edson-acordi/4bit-microcomputer/Arduino/README.md

This folder contains an Arduino program to transfer a compiled program to MikroLeo.
