edson-acordi/4bit-microcomputer/Kicad-files/README.md

This folder contains the KiCad files for Mikroleo.
