edson-acordi/4bit-microcomputer/Kicad-files/7Segment-CC/README.md

A simple seven-segment display interfaces for the MikroLeo to show hexadecimal numbers.

KiCad PCB 3D viewer:  
