edson-acordi/4bit-microcomputer/Programs/asm/vga/README.md

This folder contains some assembly language programs for MikroLeo to generate a VGA signal.
