edson-acordi/4bit-microcomputer/Kicad-files/MikroLeo/Gerber/README.md

This folder contains the Gerber files to be sent for MikroLeo PCB production.
