edson-acordi/4bit-microcomputer/Kicad-files/7Segment-CC/Gerber/README.md

This folder contains the Gerber files to be sent for 7 Segment Display PCB production.
