edson-acordi/4bit-microcomputer/Photo-Gallery/README.md

## **First steps:** ##
- Program Counter (PC)
- Reset Circuit


## **Second steps:** ##
- Program Memory (implemented with RAM)
- ROM Buffer
- Instruction Decoder (IR)
  

**Testing Pogram Memory data Retention,**
- Supercap 1.5F x 5.5V


## **Third steps:** ##
- Control Unit (UC)
  
  

## **Simposium:** ##
- Presentation at Simproin 2022
