edson-acordi/4bit-microcomputer/Programs/asm/Instruction_test/README.md

This folder holds some programs in asm code for testing with MikroLeo.
