edson-acordi/4bit-microcomputer/Docs/MikroLeo_Instruction_SET_last.pdf

## MikroLeo Instruction Set

Instruction Hex Code | Encoding of MikroLeo Instruction Word (16-bits) | | Instructions with all possibilities | Operation | Affected Flags
ROMH (8-bit) | ROML (8-bit)
High Nibble (HiNB) | Decoder Address | MAddr | Operand/LAddr
ROM (16-bit) | MICRO2_IN | AMODE | MOD | MICRO
b15 | b14 | b13:b12 | b11:b8 | b7:b4 | b3:b0
00Xn 10Xn 20Xn 30Xn | | X | 0 | 0 | X | n | LDI | LDI ACC,n | ACC ← n | ZF
| | | 1 | | | | | LDI RA,n | RA ← n | -
| | | 2 | | | | | LDI RB,n | RB ← n
| | | 3 | | | | | LDI RC,n | RC ← n
01Xn 11XX 21XX 31mn 71XX | | | 0 | 1 | X | n | NAND | NAND ACC,n | ACC ← ACC NAND n | ZF
| | | 1 | | | X | | NAND ACC,RA | ACC ← ACC NAND RA
| | | 2 | | | | | NAND ACC,RB | ACC ← ACC NAND RB
| | 0 | 3 | | MAddr | LAddr | | NAND ACC,RAM[Addr] | ACC ← ACC NAND RAM[RC:MAddr:LAddr]
| | 1 | | | X | X | | | ACC ← ACC NAND RAM[RC:RB:RA]
02mn 42XX | | 0 | 0 | 2 | MAddr | LAddr | LDW | LDW ACC,RAM[Addr] | ACC ← RAM[RC:MAddr:LAddr] | ZF
| | 1 | | | X | X | | | ACC ← RAM[RC:RB:RA]
13XX 23XX 33XX | | X | 1 | 3 | X | X | LDA | LDA RA | ACC ← RA | ZF
| | | 2 | | | | | LDA RB | ACC ← RB
| | | 3 | | | | | LDA RC | ACC ← RC
04Xn 14XX 24XX 34mn 74XX | | | 0 | 4 | X | n | OUTA | OUTA n | OUTA ← n | -
| | | 1 | | | X | | OUTA ACC | OUTA ← ACC
| | | 2 | | | | | OUTA RA | OUTA ← RA
| | 0 | 3 | | MAddr | LAddr | | OUTA RAM[Addr] | OUTA ← RAM[RC:MAddr:LAddr]
| | 1 | | | X | X | | | OUTA ← RAM[RC:RB:RA]
05Xn 15XX 25XX 35mn 75XX | | X | 0 | 5 | X | n | OUTB | OUTB n | OUTB ← n | -
| | | 1 | | | X | | OUTB ACC | OUTB ← ACC
| | | 2 | | | | | OUTB RA | OUTB ← RA
| | 0 | 3 | | MAddr | LAddr | | OUTB RAM[Addr] | OUTB ← RAM[RC:MAddr:LAddr]
| | 1 | | | X | X | | | OUTB ← RAM[RC:RB:RA]
06Xn 16XX 26XX 36mn 76XX | | X | 0 | 6 | X | n | OUTC | OUTC n | OUTC ← n | -
| | | 1 | | | X | | OUTC ACC | OUTC ← ACC
| | | 2 | | | | | OUTC RA | OUTC ← RA
| | 0 | 3 | | MAddr | LAddr | | OUTC RAM[Addr] | OUTC ← RAM[RC:MAddr:LAddr]
| | 1 | | | X | X | | | OUTC ← RAM[RC:RB:RA]
07XX | | X | 0 | 7 | X | X | NOP | NOP | No Operation | -
17XX 27XX 37XX | | | 1 | | X | X | LDR | LDR RA | RA ← ACC | -
| | | 2 | | | | | LDR RB | RB ← ACC
| | | 3 | | | | | LDR RC | RC ← ACC
08Xn 18XX 28XX 38mn 78XX | | | 0 | 8 | X | n | CMP | CMP ACC,n | ACC - n | CF, ZF
| | | 1 | | | X | | CMP ACC,RA | ACC - RA
| | | 2 | | | | | CMP ACC,RB | ACC - RB
| | 0 | 3 | | MAddr | LAddr | | CMP ACC,RAM[Addr] | ACC - RAM[RC:MAddr:LAddr]
| | 1 | | | X | X | | | ACC - RAM[RC:RB:RA]
09Xn 19XX 29XX 39mn 79XX | | X | 0 | 9 | X | n | OUTD | OUTD n | OUTD ← n | -
| | | 1 | | | X | | OUTD ACC | OUTD ← ACC
| | | 2 | | | | | OUTD RA | OUTD ← RA
| | 0 | 3 | | MAddr | LAddr | | OUTD RAM[Addr] | OUTD ← RAM[RC:MAddr:LAddr]
| | 1 | | | | | | | OUTD ← RAM[RC:RB:RA]
0Amn 4AXX | | 0 | 0 | Ah | MAddr | LAddr | STW | STW RAM[Addr],ACC | RAM[RC:MAddr:LAddr] ← ACC | -
| | 1 | | | X | X | | | RAM[RC:RB:RA] ← ACC
0BXn 1BXX 2BXX 3Bmn 7BXX | | X | 0 | Bh | X | n | SUB | SUB ACC,n | ACC ← ACC - n | CF, ZF
| | | 1 | | | X | | SUB ACC,RA | ACC ← ACC - RA
| | | 2 | | | | | SUB ACC,RB | ACC ← ACC - RB
| | 0 | 3 | | MAddr | LAddr | | SUB ACC,RAM[Addr] | ACC ← ACC - RAM[RC:MAddr:LAddr]
| | 1 | | | X | X | | | ACC ← ACC - RAM[RC:RB:RA]
0Cmn 4CXX | | 0 | 0 | Ch | MAddr | LAddr | JPI | JPI RC:MA[7:4]:LA[3:0] | PC ← [RC:MAddr:LAddr] | -
| | 1 | | | X | X | | | PC ← [RC:RB:RA]
0Dmn 4DXX | | 0 | 0 | Dh | MAddr | LAddr | JPC | JPC MA[7:4]:LA[3:0] | If CF=1, PC ← [PCH:MAddr:LAddr]
| | 1 | | | X | X | | | If CF=1, PC ← [PCH:RB:RA]
0Emn 4EXX | | 0 | 0 | Eh | MAddr | LAddr | JPZ | JPZ MA[7:4]:LA[3:0] | If ZF=1, PC ← [PCH:MAddr:LAddr]
| | 1 | | | X | X | | | If ZF=1, PC [PCH:RB:RA] ←
0FXn 1FXX 2FXX 3Fmn 7FXX | | X | 0 | Fh | X | n | ADD | ADD ACC,n | ACC ← ACC + n | CF, ZF
| | | 1 | | | X | | ADD ACC,RA | ACC ← ACC + RA
| | | 2 | | | | | ADD ACC,RB | ACC ← ACC + RB
| | 0 | 3 | | MAddr | LAddr | | ADD ACC,RAM[Addr] | ACC ← ACC + RAM[RC:MAddr:LAddr]
| | 1 | | | X | X | | | ACC ← ACC + RAM[RC:RB:RA]
8XXX 9XXX AXXX BXXX | 1 | X | 0 | X | | | INA | INA | ACC ← INA | ZF
| | | 1 | | | | INB | INB | ACC ← INB
| | | 2 | | | | INC | INC | ACC ← INC
| | | 3 | | | | IND | IND | ACC ← IND

## Mnemonic

0

LA[3:0] => can be RA or Operand (LAddr), depends on the AMODE bit. | AMODE = Addresing mode (b14)
MA[7:4] => can be RB or MAddr, depends on the AMODE bit. | MOD = Modifier bits (b13:b12)
Address = Addr => RC:MA[7:4]:LA[3:0] | MAddr = Medium Address (b7:b4)
If AMODE=0, Addr=RC:Maddr:LAddr | LAddr = Low Address (b3:b0)
If AMODE=1, Addr=RC:RB:RA | MICRO = Instruction (b11:b8)
X = don't care | OPCODE = AMODE:MOD:MICRO
MAddr = m, so the names are interchangeable | ZF = Zero Flag
Operand = n, so the names are interchangeable | CF = Carry Flag
