edson-acordi/4bit-microcomputer/Docs/FAQ.md

### Frequently Asked Questions about MikroLeo ###  

**1) What is MikoLeo?**  
A: MikroLeo is a 4-bit microcomputer developed mainly for educational purposes and distributed for free under open-source licenses.
