edson-acordi/4bit-microcomputer/Docs/MikroLeo_v0.1901_Rev1.01A_sch.pdf

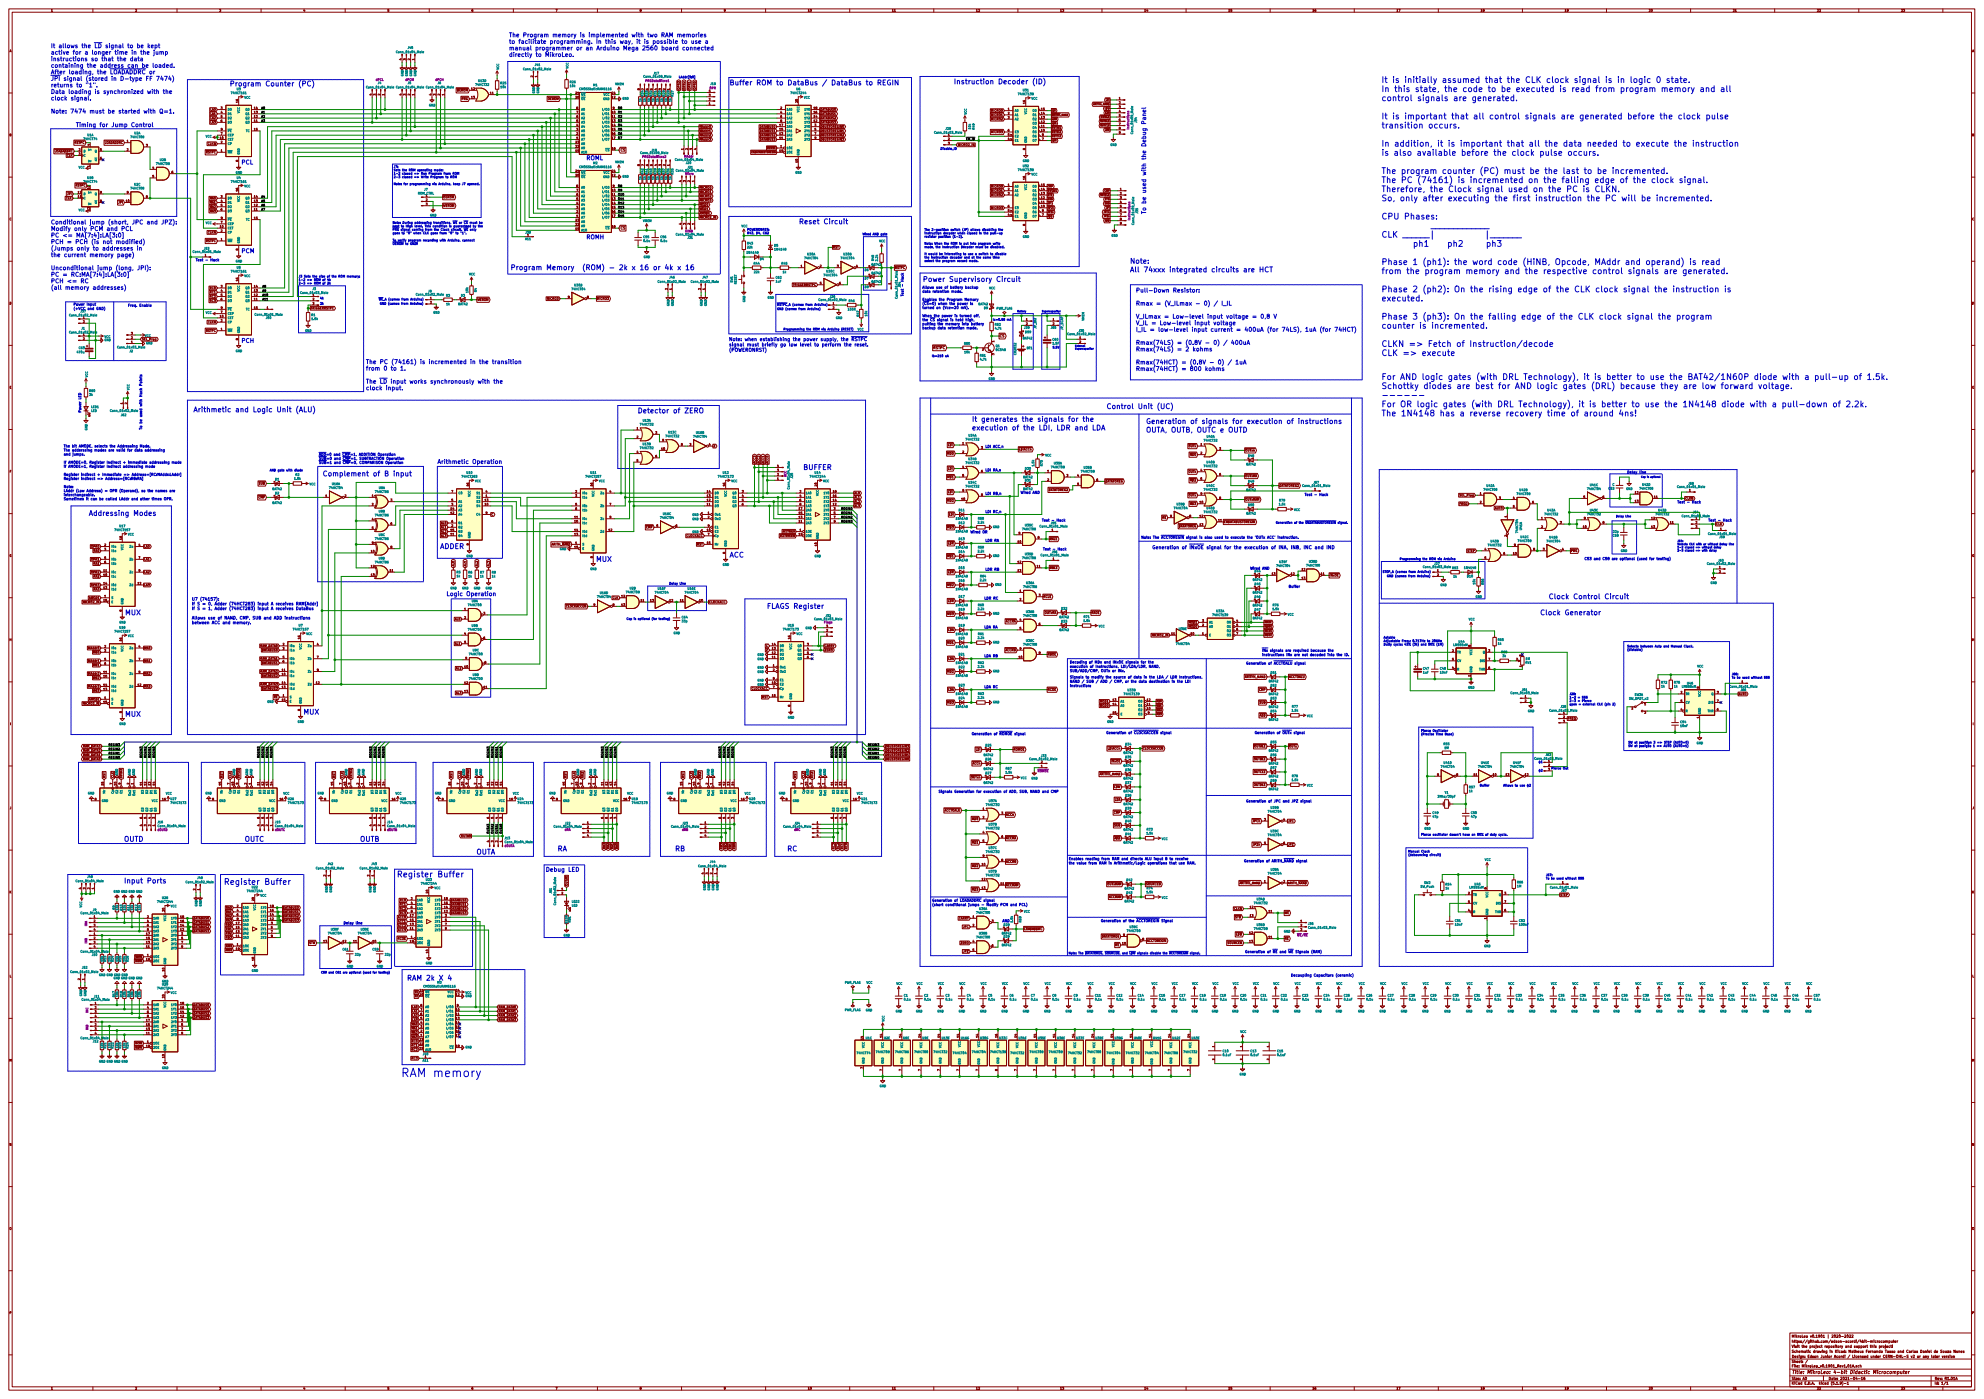
[picture p14: page 1]

The Program memory is implemented with two RAM memories
to facilitate programming. In this way, it is possible to use a
manual programmer or an Arduino Mega 2560 board connected
directly to MikroLeo.

It allows the LD signal to be kept
active for a longer time in the jump
instructions so that the data
containing the address can be loaded.
After loading, the LOADADDRC or
JPI signal (stored in D-type FF 7474)
returns to "1".

Buffer ROM to DataBus / DataBus to REGIN

It is initially assumed that the CLK clock signal is in logic 0 state.
In this state, the code to be executed is read from program memory and all

Data loading is synchronized with the
clock signal.

control signals are generated.

Note: 7474 must be started with Q=1.

It is important that all control signals are generated before the clock pulse
transition occurs.

DATABUS2 RSTPC
Timing for Jump Control

In addition, it is important that all the data needed to execute the instruction
is also available before the clock pulse occurs.

select the program record mode. J7: Sets the ROM operating mode:

The program counter (PC) must be the last to be incremented.
The PC (74161) is incremented on the falling edge of the clock signal.
Therefore, the Clock signal used on the PC is CLKN.
So, only after executing the first instruction the PC will be incremented.

1-2 closed => Run Program from ROM
2-3 closed => Write Program to ROM

Note: for programming via Arduino, keep J7 opened.

Modify only PCM and PCL
PCH = PCH (is not modified)
(Jumps only to addresses in
the current memory page)

Note: During addressing transitions, WE or CS must be
kept to High level. This condition is guaranteed by the
PRG signal coming from the Clock circuit. WE only
goes to "0" when CLK goes from "0" to "1".

The 2-position switch (JP) allows disabling the
instruction decoder when closed in the pull-up
resistor position (1-2).

To verify program recording with Arduino, connect OEROM to GND! 2k

Note: When the ROM is put into program write mode, the Instruction Decoder must be disabled.

It would be interesting to use a switch to disable
the instruction decoder and at the same time

Note:
All 74xxx integrated circuits are HCT

Phase 1 (ph1): the word code (HiNB, Opcode, MAddr and operand) is read
from the program memory and the respective control signals are generated.

Unconditional jump (long, JPI):
PCH <= RC

J3 Sets the size of the ROM memory: 1-2 => ROM of 4k 2-3 => ROM of 2k

Allows use of battery backup
data retention mode. Enables the Program Memory

Phase 2 (ph2): On the rising edge of the CLK clock signal the instruction is
executed.

WE_A (comes from Arduino)
GND (comes from Arduino)

RSTPC_A (comes from Arduino)

(CS=0) when the power is
turned on (Vce=20 mV).

Battery ADD=0 and CMP=1, ADDITION Operation

Phase 3 (ph3): On the falling edge of the CLK clock signal the program
counter is incremented.

When the power is turned off,
the CS signal is held high,
putting the memory into battery

V_ILmax = Low-level input voltage = 0,8 V
V_IL = Low-level input voltage
I_IL = low-level input current = 400uA (for 74LS), 1uA (for 74HCT)

Programming the ROM via Arduino (RESET)

Note: when establishing the power supply, the RSTPC
signal must briefly go low level to perform the reset.
(POWERONRST)

CLKN => Fetch of Instruction/decode
CLK => execute

The PC (74161) is incremented in the transition
from 0 to 1.

For AND logic gates (with DRL Technology), it is better to use the BAT42/1N60P diode with a pull-up of 1.5k.
Schottky diodes are best for AND logic gates (DRL) because they are low forward voltage. ------ For OR logic gates (with DRL Technology), it is better to use the 1N4148 diode with a pull-down of 2.2k.

The LD input works synchronously with the
clock input.

Logic Operation To be used with Hack Points

LDI ACC,n Power LED

Arithmetic and Logic Unit (ALU)

The 1N4148 has a reverse recovery time of around 4ns!

It generates the signals for the
execution of the LDI, LDR and LDA

Generation of signals for execution of instructions
OUTA, OUTB, OUTC e OUTD

The bit AMODE, selects the Addressing Mode.
The adderssing modes are valid for data addressing
and jumps.

SUB=0 and CMP=1, SUBTRACTION Operation
SUB=1 and CMP=0, COMPARISON Operation
Complement of B input

If AMODE=0, Register Indirect + immediate addressing mode
if AMODE=1, Register Indirect addressing mode

LDI RAM_DATA0
AND gate with diode

Register indirect + Immediate => Address=[RC:MAddr:LAddr]
Register indirect => Address=[RC:RB:RA] Note: LAddr (Low Address) = OPR (Operand), so the names are

Cap is optional RAM memory

Test - Hack Generation of OUTx signal

Allows to use 2 Addressing Modes

Generation of the ENDATABUSTOREGIN signal.

Note: The ACCTOREGIN signal is also used to execute the 'OUTx ACC' instruction.
Generation of INxOE signal for the execution of INA, INB, INC and IND

J64: Selects CLK with or without Delay line

1-2 closed => without delay 2-3 closed => with delay

Programming the ROM via Arduino

C53 and C58 are optional (used for testing)

STEP_A (comes from Arduino)

If S = 0, Adder (74HCT283) input A receives RAM[Addr]
If S = 1, Adder (74HCT283) input A receives DataBus

Allows use of NAND, CMP, SUB and ADD instructions
between ACC and memory.

Cap is optional (for testing)

Astable Adjustable Freq.: 0.717Hz to 206Hz

GND GND GND GND GND

Selects between Auto and Manual Clock. (bistable)

INx signals are required because the
instructions INx are not decoded into the ID.

Decoding of MDx and INxOE signals for the
execution of Instructions, LDI/LDA/LDR, NAND,
SUB/ADD/CMP, OUTx or INx.
Signals to modify the source of data in the LDA / LDR Instructions,
NAND / SUB / ADD / CMP, or the data destination in the LDI

J66: To be used without 555

2-3 = Pierce
open = external CLK (pin 2)

SW at position 3 => STEP (AUTO=0)
SW at posição 1 => AUTO (AUTO=1)

2 Enables reading from RAM and directs ALU input B to receive

Signals Generation for execution of ADD, SUB, NAND and CMP

Generation of JPC and JPZ signal

Pierce oscillator doesn't have an 50% of duty cycle.

the value from RAM in Arithmetic/Logic operations that use RAM.

J67: To be used without 555

Generation of LOADADDRC signal
(short conditional jumps - Modify PCM and PCL)

Note: The DATATOREG, SOURCEB, and LDW signals disable the ACCTOREGIN signal.

Generation of RE and WE Signals (RAM)

C59 and C61 are optional (used for testing)

VCC GND VCC 14 GND

MikroLeo v0.1901 | 2020-2022
https://github.com/edson-acordi/4bit-microcomputer
Visit the project repository and support this project!
Schematic drawing in Kicad: Matheus Fernando Tasso and Carlos Daniel de Souza Nunes
File: MikroLeo_v0.1901_Rev1.01A.sch Sheet: / Design: Edson Junior Acordi / Licensed under CERN-OHL-S v2 or any later version

Id: 1/1 Title: MikroLeo: 4-bit Didactic Microcomputer
