edson-acordi/4bit-microcomputer/Docs/7Segment_CC_Bin_Hex_sch.pdf

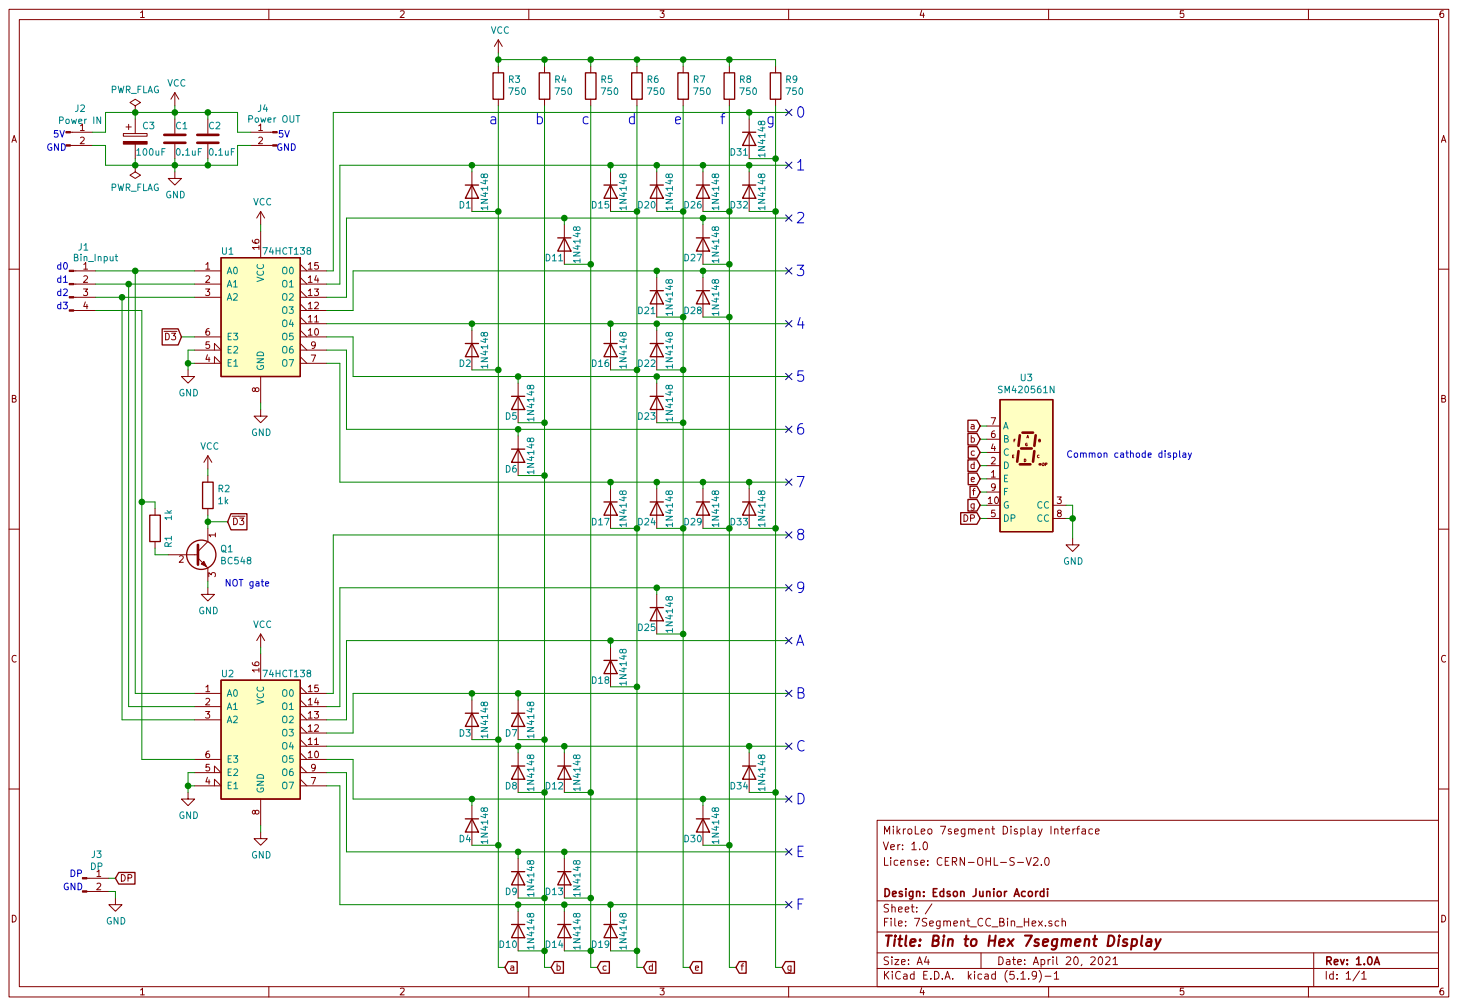
[picture p15: page 1]

NOT gate DP GND

File: 7Segment_CC_Bin_Hex.sch Sheet: / Design: Edson Junior Acordi License: CERN-OHL-S-V2.0 Ver: 1.0 MikroLeo 7segment Display Interface

Id: 1/1 Title: Bin to Hex 7segment Display
