edson-acordi/4bit-microcomputer/Docs/VGA/Updated VGA Flowchart.pdf

## Flowchart for generating a 640x480 VGA image at 60Hz

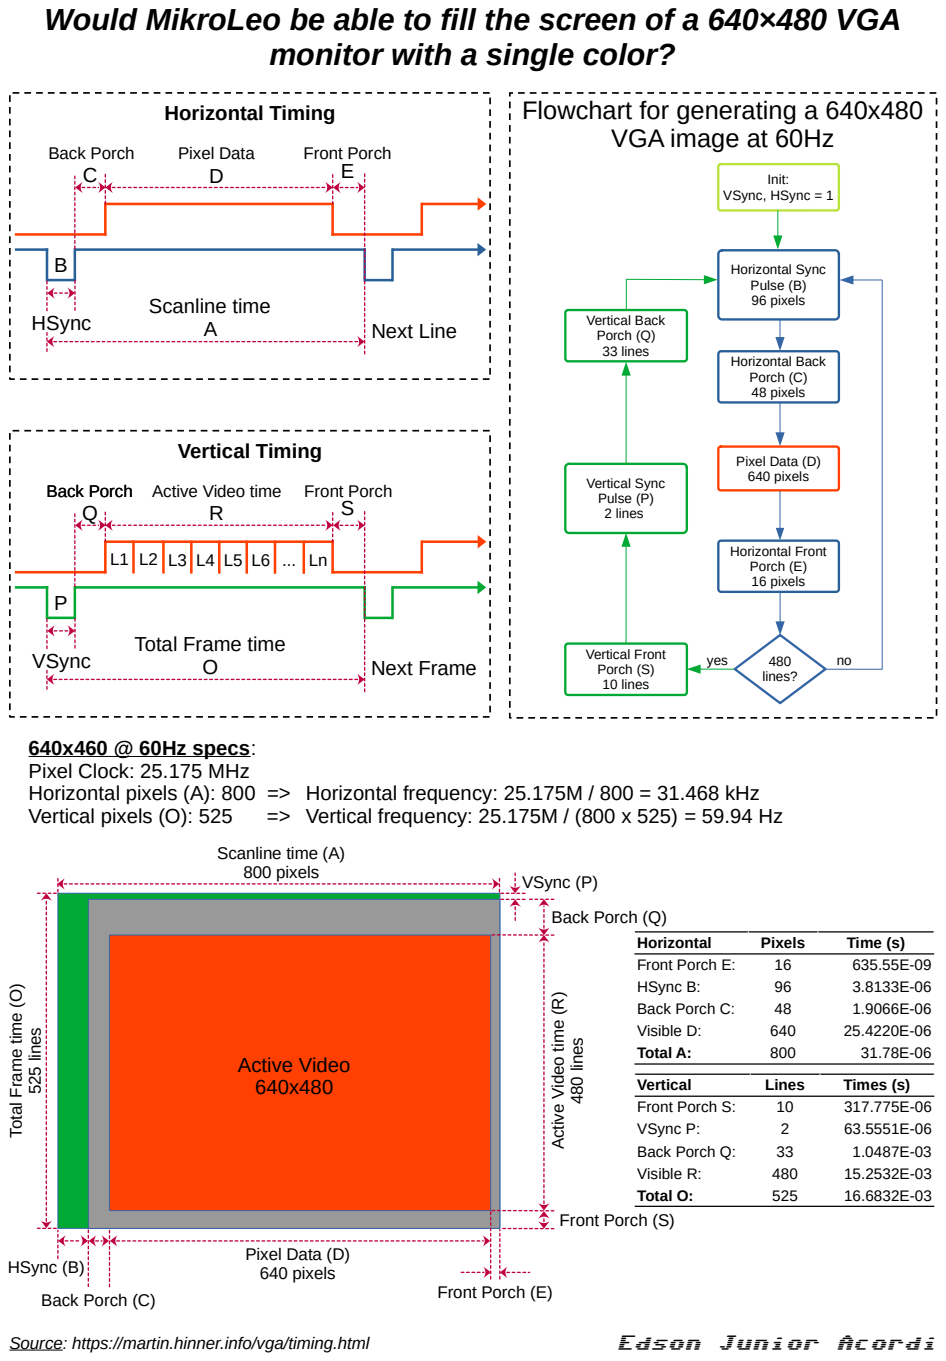
[picture p16: page 1]
Vertical Sync; Pulse (P) 2 lines; Vertical Back; Porch (Q) 33 lines; Horizontal Sync; Pulse (B); 96 pixels; Init:; VSync, HSync = 1; Horizontal Back; Porch (C) 48 pixels; Pixel Data (D); 640 pixels; Horizontal Front Porch (E); 16 pixels; 480 lines?; yes; no Vertical Front; Porch (S) 10 lines; HSync; Back Porch; Pixel Data; Front Porch; Scanline time; Next Line; Horizontal Timing; VSync; Active Video time; Next Frame; Vertical Timing; Vertical pixels (O): 525; VSync (P); Back Porch (Q); Activ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

Would MikroLeo be able to fill the screen of a 640×480 VGA

monitor with a single color?

Total Frame time

640x460 @ 60Hz specs:
Pixel Clock: 25.175 MHz
Horizontal pixels (A): 800 =>

Horizontal frequency: 25.175M / 800 = 31.468 kHz
Vertical frequency: 25.175M / (800 x 525) = 59.94 Hz

Horizontal | Pixels | Time (s)

Front Porch E: | 16 | 635.55E-09

HSync B: | 96 | 3.8133E-06

Back Porch C: | 48 | 1.9066E-06

Visible D: | 640 | 25.4220E-06

Total A: | 800 | 31.78E-06

Vertical | Lines | Times (s)

Front Porch S: | 10 | 317.775E-06

VSync P: | 2 | 63.5551E-06

Back Porch Q: | 33 | 1.0487E-03

Visible R: | 480 | 15.2532E-03

Total O: | 525 | 16.6832E-03
