edson-acordi/4bit-microcomputer/(commit log)

2022-10-28 Create Kicad-Files
    Kicad project files
2022-10-28 Add files via upload
    Schematic
2022-10-28 Update README.md
    Kicad projects files
